barisdinc/SimpleButUsefulGPSDO/Research/cover-image.webp

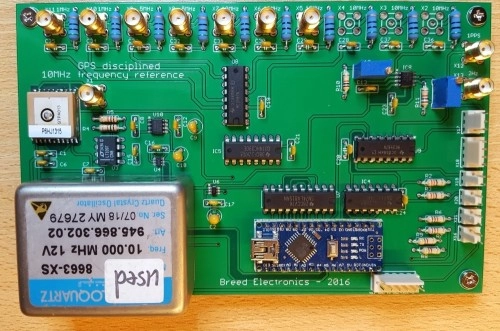
Research/cover-image.webp
