barisdinc/SimpleButUsefulGPSDO/Research/FZAFXOIJGZMGJO0.png

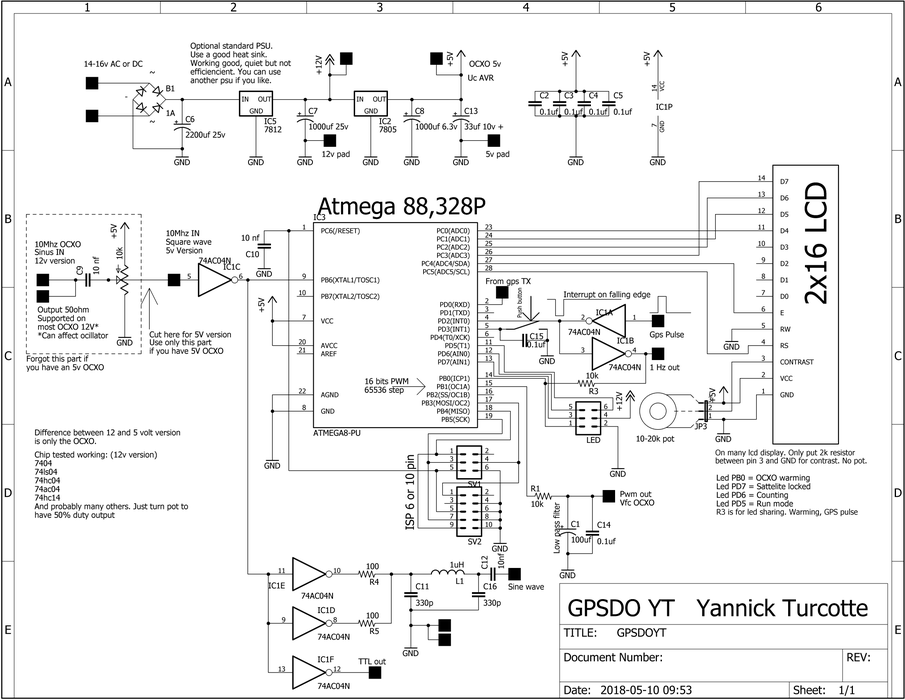
Research/FZAFXOIJGZMGJO0.png
