barisdinc/SimpleButUsefulGPSDO/Research/gpsdo architecture.gif

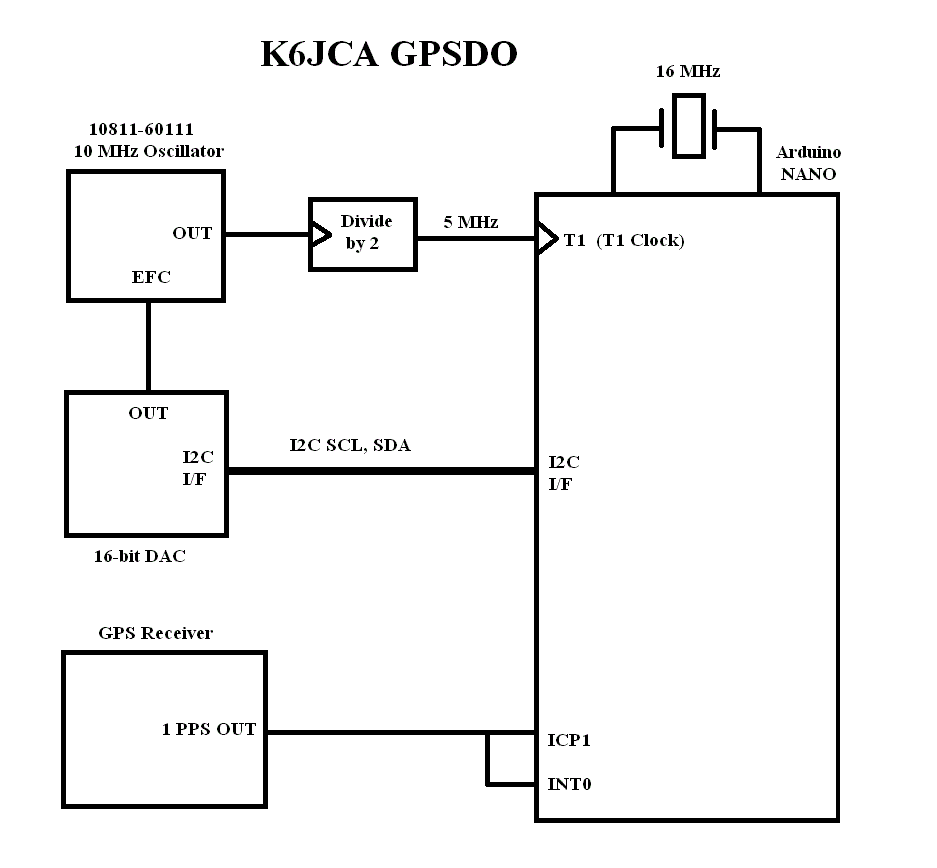
Research/gpsdo architecture.gif
