barisdinc/SimpleButUsefulGPSDO/Research/GPS_SI5351a.pdf

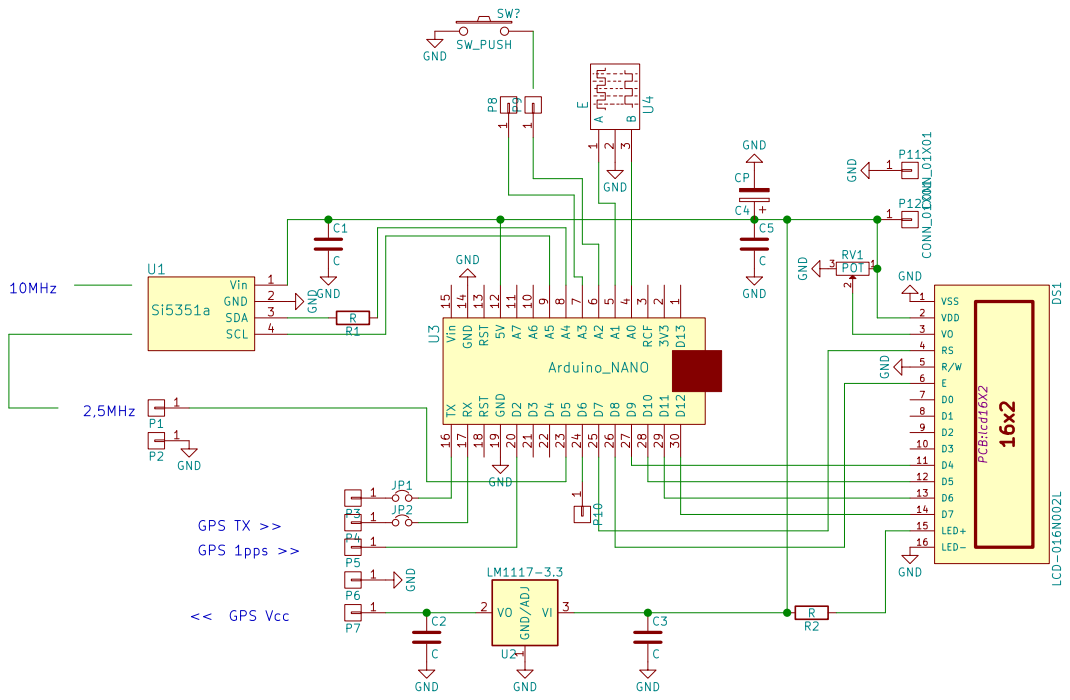
[picture p12: page 1]
