barisdinc/SimpleButUsefulGPSDO/(commit log)

2020-08-17 schematic and PCB.. initial version
    [GPSDO.kicad_pcb, GPSDO.sch]
2023-02-02 40MHz reference update
    Frequency is set to 40 Mhz (previously was 10 MHz but corrected to 40)
    Thanks to Bora Kilerci (TA1BFE)
    [SimpleGPSDO.ino]
